straytech/YM_MINI/YM_Mini_schematic.pdf

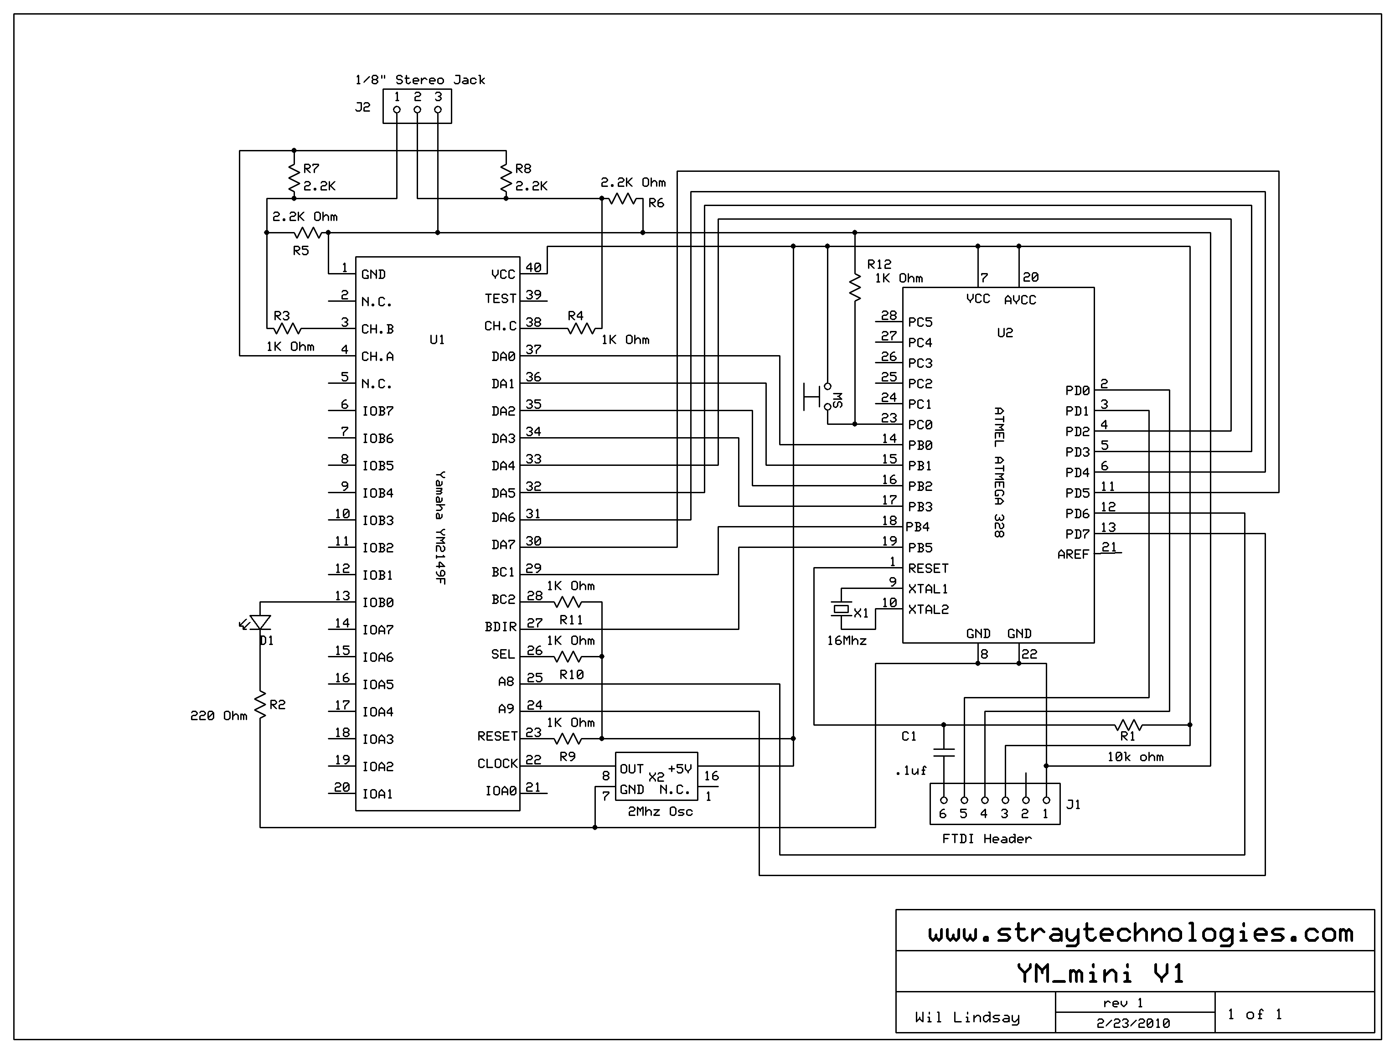
[picture p1: page 1]
